AgustinM93/Proyecto-SistemasEmbebidos/Link videos funcionamiento.txt

1- funcionando inalambricamente   https://www.youtube.com/watch?v=fEkzHs_U7fE
2- funcionando con cable          https://www.youtube.com/watch?v=LjpG7Ot_ENg

3- video que enviamos previamente a José: 
	https://drive.google.com/file/d/1Yy4lDLHPL2rxEJQST_wPQXoMdtzMLk4Y/view?usp=share_link
